BobGlicksman/OpenSourceController/Hardware/ControllerCaseLayout - to scale.pdf

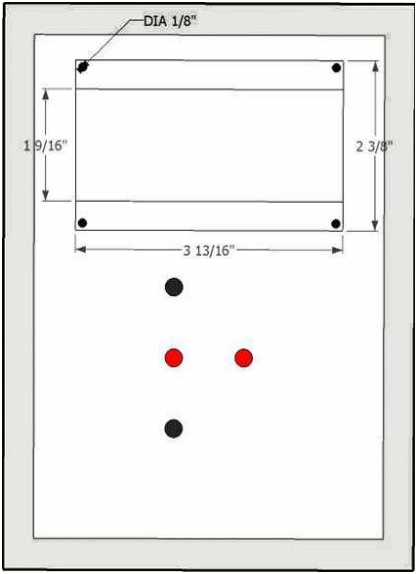
[picture p1: figure]
