BobGlicksman/OpenSourceController/Hardware/Still Controller Parts List - unit and vendor sorted.xls

Sheet: Parts
Assembly | Qty | Device | Description | From | Part Num | URL | Price | Total | Notes
Controller Box | 1 | Box | Plastic box, 1.75L, 3"H x 7"W x 9-1/2"D, Clear | Office Depot | -- | http://www.officedepot.com/a/products/452333/Really-Useful-Boxes-Plastic-Storage-Box/#firstTab | $4.49 | $4.49 | OEM is "Really Useful Boxes". Can be ordered on-line from Office Deport or the OEM, or purchased at Office Depot retail store.
 | 1 | Arduino Uno R3 | Microcontroller | Jameco | A000066 | http://www.jameco.com/webapp/wcs/stores/servlet/Product_10001_10001_2151486_-1 | $29.95 | $29.95 | Also available from Adafruit, Sparkfun Electronics and others
 | 1 | LCD Module | 20x4 character LCD module with I2C interface | B2QCShop | -- | http://b2cqshop.com/products/192-arduino-i2c-serial-2004-lcd-module-20x4-iic-twi-lcd.aspx | $18.50 | $18.50 | Alternate module and I2C backboard are available from Adafruit Industries, but costs more and takes some assembly
 | 2 | Pushbutton | Pushbutton Switch - red | Tayda Electronics | A-5051 | http://www.taydaelectronics.com/electromechanical/switches-key-pad/push-button/pb-11d02-push-button-panel-mount-spst-no-pb-11d02-th1r00.html | $0.22 | $0.44 | Also available at Radio Shack stores
 | 2 | Pushbutton | Pushbutton Switch - black | Tayda Electronics | A-5050 | http://www.taydaelectronics.com/electromechanical/switches-key-pad/push-button/pb-11d02-push-button-panel-mount-spst-no-pb-11d02-th1-00.html | $0.25 | $0.50 | Also available at Radio Shack stores
 | 1 | Power Supply | 9 VDC, 1000 ma switching power supply | Adafruit | 63 | http://www.adafruit.com/products/63 | $6.95 | $6.95
 | 1 | Audible Alert | Piezo electric tone buzzer | Tayda Electronics | A-5019 | http://www.taydaelectronics.com/piezo-electronic-tone-buzzer-alarm-1-5-28v-pcb.html | $1.12 | $1.12 | A similar model with leads is available from this source as well.
 | 2 | Terminal Block | Terminal Block - 8 position | Jameco | 231036 | http://www.jameco.com/webapp/wcs/stores/servlet/ProductDisplay?langId=-1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 | $2.89 | $5.78
 | 1 | Terminal Block | Terminal Block - 3 position | Jameco | 230981 | http://www.jameco.com/webapp/wcs/stores/servlet/ProductDisplay?langId=-1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 | $1.49 | $1.49
 | 6 | Jumper | Terminal Block Jumper | Jameco | 659382 | http://www.jameco.com/webapp/wcs/stores/servlet/ProductDisplay?langId=-1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 | $0.29 | $1.74
 | 1 | Nylon Screw | Bag of #4-40 Nylon screw, 1/2" | Fry's Electronics | 3579664 | http://www.frys.com/product/3579664?site=sr:SEARCH:MAIN_RSLT_PG | $1.95 | $1.95 | Can be purchased in most any hardware store
 | 8 | Nylon Nut | #4-40 Nylon nut, 2 pack | Home Depot | 594623 | http://www.homedepot.com/h_d1/N-5yc1v/R-202210238/h_d2/ProductDisplay?langId=-1&storeId=10051&catalogId=10053 | $0.37 | $2.96 | Can be purchased in most any hardware store
 | 12 | Machine Screw | #6-32 machine screw, 1/2" | Home Depot | 749347 | http://www.homedepot.com/h_d1/N-5yc1v/R-202209804/h_d2/ProductDisplay?langId=-1&storeId=10051&catalogId=10053 | $0.47 | $5.64 | Can be purchased in most any hardware store
 | 6 | Nut | #6-32 nut, pack of 4 | Home Depot | 254827 | http://www.homedepot.com/h_d1/N-5yc1v/R-202706349/h_d2/ProductDisplay?langId=-1&storeId=10051&catalogId=10053 | $1.18 | $7.08 | Can be purchased in most any hardware store
 | 1 | Cable for LCD | 2 pcs, cables for I2C Serial LCD module | B2QCShop | -- | http://b2cqshop.com/products/193-2-pcs-cables-for-iic-serial-lcd-module-i2c-for-arduino-diy.aspx | $3.00 | $3.00
 | 1 | 6-pin wire jumpers | 6 pcs, 6 pin wire jumper cables | B2QCShop | -- | http://b2cqshop.com/products/170-6-pcs-6-pin-wire-jumpers-female-to-female-for-arduino.aspx | $4.50 | $4.50
Subtotal - Controller Box |  |  |  |  |  |  |  | $96.09
Shield Board | 1 | PC Board | Arduino shield printed circuit board for open source controller | BatchPCB |  | http://www.batchpcb.com/product_info.php?products_id=75513&check=a69606452bf49d346372d5d822638f62 | $13.80 | $13.80
 | 1 | Header kit | Set of 4 headers for Arduino Uno shield board | Jameco | 2137756 | http://www.jameco.com/webapp/wcs/stores/servlet/ProductDisplay?langId=-1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 | $1.75 | $1.75
 | 1 | Pin Header, male | 40 position header, 0.1", breakable | Jameco | 7000-1X40SG-R | http://www.jameco.com/webapp/wcs/stores/servlet/Product_10001_10001_160882_-1 | $0.65 | $0.65
 | 2 | 16 pin DIP socket | 16 pin DIP socket, solder tail, 0.3" wide | Jameco | 6100-16-R | http://www.jameco.com/webapp/wcs/stores/servlet/Product_10001_10001_37402_-1 | $0.75 | $1.50
 | 1 | 10 pin SIP socket | 10 pin SIP socket, solder tail | Jameco | 6100-1X10-R (http://www.jameco.com/webapp/wcs/stores/servlet/Product_10001_10001_102201_-1) | http://www.jameco.com/webapp/wcs/stores/servlet/Product_10001_10001_102201_-1 | $1.19 | $1.19
 | 1 | 74HC165 | 74HC165 octal, latched, shift in register, 16 pin DIP | Tayda Electronics | A-639 | http://www.taydaelectronics.com/74hc165-74165-ic-8-bit-shift-register.html | $0.34 | $0.34
 | 1 | 74HC595 | 74HC595 octal, latched, shift out register, 16 pin DIP | Tayda Electronics | A-251 | http://www.taydaelectronics.com/74hc595-8-bit-shift-register-ic.html | $0.20 | $0.20
 | 1 | Resistor network | 10 pin, pull-up resistor network, 4.7K ohm | Jameco | 10BRN4.7K | http://www.jameco.com/webapp/wcs/stores/servlet/Product_10001_10001_24660_-1 | $0.19 | $0.19
 | 1 | capacitor, 100 uf | 100 uf electrolytic capacitor | Tayda Electronics | A-4514 | http://www.taydaelectronics.com/capacitors/electrolytic-capacitors/100uf-10v-105c-radial-electrolytic-capacitor-5x11mm.html | $0.02 | $0.02
 | 1 | capacitor, 0.01 uf | 0.01 uf ceramic capacitor, package of 10 | Tayda Electronics | A-550 | http://www.taydaelectronics.com/capacitors/ceramic-disc-capacitors/10-x-0-01uf-50v-ceramic-disc-capacitor-pkg-of-10.html | $0.10 | $0.10
 | 1 | LED | Yellow LED - 5 mm | Sparkfun | COM-00532 | http://www.sparkfun.com/products/532 | $0.35 | $0.35
 | 10 | resistor, 560 ohm | unit of 10 resistors, 560 ohm, 1/4 watt | Tayda Electronics | A-2282 | http://www.taydaelectronics.com/10-x-resistor-560-ohm-1-4w-1-metal-film-pkg-of-10.html | $0.01 | $0.10
 | 1 | switch | N.O. pushbutton switch, PC mount | Sparkfun | COM-0097 | http://www.sparkfun.com/products/97 | $0.35 | $0.35
Subtotal - Shield Board |  |  |  |  |  |  |  | $20.54
Test Board | 1 | Breadboard | Full sized solderless breadboard | Adafruit | 239 | https://www.adafruit.com/products/239 | $8.00 | $8.00
 | 3 | Screw Terminal, 3 pos | Connector terminal block, 3 position, 5.08 mm, solder straight through | Jameco | 152355 | http://www.jameco.com/webapp/wcs/stores/servlet/ProductDisplay?langId=-1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 | $0.49 | $1.47
 | 1 | Screw Terminal, 2 pos | Connector terminal block, 3 position, 5.08 mm, solder straight through | Jameco | 152347 | http://www.jameco.com/webapp/wcs/stores/servlet/ProductDisplay?langId=-1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 | $0.65 | $0.65
 | 7 | LED | Yellow LED - 5 mm | Sparkfun | COM-00532 | http://www.sparkfun.com/products/532 | $0.35 | $2.45
 | 0 | resistor, 560 ohm | unit of 10 resistors, 560 ohm, 1/4 watt | Tayda Electronics | A-2282 | http://www.taydaelectronics.com/10-x-resistor-560-ohm-1-4w-1-metal-film-pkg-of-10.html | $0.01 | $0.00 | included in item #31
 | 1 | Jumper Wires | Bag of 10, 6" M/M jumpers | Sparkfun Electronics | PRT-08431 | http://www.sparkfun.com/products/8431 | $3.95 | $3.95
 | 3 | DS18B20 | One-wire bus temperature sensor | Tayda Electronics | A-072 | http://www.taydaelectronics.com/ic-integrated-circuits/temperature-sensors/ds18b20-1-wire-digital-temperature-sensor-ic-dallas.html | $1.75 | $5.25
Subtotal - Test Board |  |  |  |  |  |  |  | $21.77
Misc | 1 | USB Cable | USB Cable, A-B, 3 ft. | Adafruit | 62 | http://www.adafruit.com/products/62 | $4.00 | $4.00
 | 1 | Hookup Wire | 22 AWG stranded, 25' ea. Red, green and black | Radio Sack | 278-1224 | http://www.radioshack.com/product/index.jsp?productId=2049745 | $7.49 | $7.49
 | 1 | Solder | 8 oz roll of rosin core solder | Radio Shack | 64-009 | http://www.radioshack.com/product/index.jsp?productId=2062715 | $11.99 | $11.99
 | 100 | Cable Ties | Bag of cable ties | Jameco | 70561 | http://www.jameco.com/webapp/wcs/stores/servlet/Product_10001_10001_70561_-1?CID=PDF | $0.03 | $3.00
 | 15 | Tie Mounts | Nylon cable tie mount, 3/4 inch, adhesive | Jameco | 182942 | http://www.jameco.com/webapp/wcs/stores/servlet/Product_10001_10001_182942_-1 | $0.15 | $2.25
Subtotal - Misc |  |  |  |  |  |  |  | $28.73
TOTAL |  |  |  |  |  |  |  | $167.13

Sheet: Order
Controller Box | 1 | Power Supply | 9 VDC, 1000 ma switching power supply | Adafruit | 63 | http://www.adafruit.com/products/63 | $6.95 | $6.95
Misc | 1 | USB Cable | USB Cable, A-B, 3 ft. | Adafruit | 62 | http://www.adafruit.com/products/62 | $4.00 | $4.00
Test Board | 1 | Breadboard | Full sized solderless breadboard | Adafruit | 239 | https://www.adafruit.com/products/239 | $8.00 | $8.00
Controller Box | 1 | LCD Module | 20x4 character LCD module with I2C interface | B2QCShop | -- | http://b2cqshop.com/products/192-arduino-i2c-serial-2004-lcd-module-20x4-iic-twi-lcd.aspx | $18.50 | $18.50 | Alternate module and I2C backboard are available from Adafruit Industries, but costs more and takes some assembly
Controller Box | 1 | Cable for LCD | 2 pcs, cables for I2C Serial LCD module | B2QCShop | -- | http://b2cqshop.com/products/193-2-pcs-cables-for-iic-serial-lcd-module-i2c-for-arduino-diy.aspx | $3.00 | $3.00
Controller Box | 1 | 6-pin wire jumpers | 6 pcs, 6 pin wire jumper cables | B2QCShop | -- | http://b2cqshop.com/products/170-6-pcs-6-pin-wire-jumpers-female-to-female-for-arduino.aspx | $4.50 | $4.50
Shield Board | 1 | PC Board | Arduino shield printed circuit board for open source controller | BatchPCB |  | http://www.batchpcb.com/product_info.php?products_id=75513&check=a69606452bf49d346372d5d822638f62 | $13.80 | $13.80
Controller Box | 1 | Nylon Screw | Bag of #4-40 Nylon screw, 1/2" | Fry's Electronics | 3579664 | http://www.frys.com/product/3579664?site=sr:SEARCH:MAIN_RSLT_PG | $1.95 | $1.95 | Can be purchased in most any hardware store
Controller Box | 8 | Nylon Nut | #4-40 Nylon nut, 2 pack | Home Depot | 594623 | http://www.homedepot.com/h_d1/N-5yc1v/R-202210238/h_d2/ProductDisplay?langId=-1&storeId=10051&catalogId=10053 | $0.37 | $2.96 | Can be purchased in most any hardware store
Controller Box | 12 | Machine Screw | #6-32 machine screw, 1/2" | Home Depot | 749347 | http://www.homedepot.com/h_d1/N-5yc1v/R-202209804/h_d2/ProductDisplay?langId=-1&storeId=10051&catalogId=10053 | $0.47 | $5.64 | Can be purchased in most any hardware store
Controller Box | 6 | Nut | #6-32 nut, pack of 4 | Home Depot | 254827 | http://www.homedepot.com/h_d1/N-5yc1v/R-202706349/h_d2/ProductDisplay?langId=-1&storeId=10051&catalogId=10053 | $1.18 | $7.08 | Can be purchased in most any hardware store
Controller Box | 1 | Arduino Uno R3 | Microcontroller | Jameco | A000066 | http://www.jameco.com/webapp/wcs/stores/servlet/Product_10001_10001_2151486_-1 | $29.95 | $29.95 | Also available from Adafruit, Sparkfun Electronics and others
Controller Box | 2 | Terminal Block | Terminal Block - 8 position | Jameco | 231036 | http://www.jameco.com/webapp/wcs/stores/servlet/ProductDisplay?langId=-1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 | $2.89 | $5.78
Controller Box | 1 | Terminal Block | Terminal Block - 3 position | Jameco | 230981 | http://www.jameco.com/webapp/wcs/stores/servlet/ProductDisplay?langId=-1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 | $1.49 | $1.49
Controller Box | 6 | Jumper | Terminal Block Jumper | Jameco | 659382 | http://www.jameco.com/webapp/wcs/stores/servlet/ProductDisplay?langId=-1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 | $0.29 | $1.74
Misc | 100 | Cable Ties | Bag of cable ties | Jameco | 70561 | http://www.jameco.com/webapp/wcs/stores/servlet/Product_10001_10001_70561_-1?CID=PDF | $0.03 | $3.00
Misc | 15 | Tie Mounts | Nylon cable tie mount, 3/4 inch, adhesive | Jameco | 182942 | http://www.jameco.com/webapp/wcs/stores/servlet/Product_10001_10001_182942_-1 | $0.15 | $2.25
Shield Board | 1 | Header kit | Set of 4 headers for Arduino Uno shield board | Jameco | 2137756 | http://www.jameco.com/webapp/wcs/stores/servlet/ProductDisplay?langId=-1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 | $1.75 | $1.75
Shield Board | 1 | Pin Header, male | 40 position header, 0.1", breakable | Jameco | 7000-1X40SG-R | http://www.jameco.com/webapp/wcs/stores/servlet/Product_10001_10001_160882_-1 | $0.65 | $0.65
Shield Board | 2 | 16 pin DIP socket | 16 pin DIP socket, solder tail, 0.3" wide | Jameco | 6100-16-R | http://www.jameco.com/webapp/wcs/stores/servlet/Product_10001_10001_37402_-1 | $0.75 | $1.50
Shield Board | 1 | 10 pin SIP socket | 10 pin SIP socket, solder tail | Jameco | 6100-1X10-R (http://www.jameco.com/webapp/wcs/stores/servlet/Product_10001_10001_102201_-1) | http://www.jameco.com/webapp/wcs/stores/servlet/Product_10001_10001_102201_-1 | $1.19 | $1.19
Shield Board | 1 | Resistor network | 10 pin, pull-up resistor network, 4.7K ohm | Jameco | 10BRN4.7K | http://www.jameco.com/webapp/wcs/stores/servlet/Product_10001_10001_24660_-1 | $0.19 | $0.19
Test Board | 3 | Screw Terminal, 3 pos | Connector terminal block, 3 position, 5.08 mm, solder straight through | Jameco | 152355 | http://www.jameco.com/webapp/wcs/stores/servlet/ProductDisplay?langId=-1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 | $0.49 | $1.47
Test Board | 1 | Screw Terminal, 2 pos | Connector terminal block, 3 position, 5.08 mm, solder straight through | Jameco | 152347 | http://www.jameco.com/webapp/wcs/stores/servlet/ProductDisplay?langId=-1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 | $0.65 | $0.65
Controller Box | 1 | Box | Plastic box, 1.75L, 3"H x 7"W x 9-1/2"D, Clear | Office Depot | -- | http://www.officedepot.com/a/products/452333/Really-Useful-Boxes-Plastic-Storage-Box/#firstTab | $4.49 | $4.49 | OEM is "Really Useful Boxes". Can be ordered on-line from Office Deport or the OEM, or purchased at Office Depot retail store.
Misc | 1 | Hookup Wire | 22 AWG stranded, 25' ea. Red, green and black | Radio Sack | 278-1224 | http://www.radioshack.com/product/index.jsp?productId=2049745 | $7.49 | $7.49
Misc | 1 | Solder | 8 oz roll of rosin core solder | Radio Shack | 64-009 | http://www.radioshack.com/product/index.jsp?productId=2062715 | $11.99 | $11.99
Shield Board | 1 | LED | Yellow LED - 5 mm | Sparkfun | COM-00532 | http://www.sparkfun.com/products/532 | $0.35 | $0.35
Shield Board | 1 | switch | N.O. pushbutton switch, PC mount | Sparkfun | COM-0097 | http://www.sparkfun.com/products/97 | $0.35 | $0.35
Test Board | 7 | LED | Yellow LED - 5 mm | Sparkfun | COM-00532 | http://www.sparkfun.com/products/532 | $0.35 | $2.45
Test Board | 1 | Jumper Wires | Bag of 10, 6" M/M jumpers | Sparkfun Electronics | PRT-08431 | http://www.sparkfun.com/products/8431 | $3.95 | $3.95
Controller Box | 2 | Pushbutton | Pushbutton Switch - red | Tayda Electronics | A-5051 | http://www.taydaelectronics.com/electromechanical/switches-key-pad/push-button/pb-11d02-push-button-panel-mount-spst-no-pb-11d02-th1r00.html | $0.22 | $0.44 | Also available at Radio Shack stores
Controller Box | 2 | Pushbutton | Pushbutton Switch - black | Tayda Electronics | A-5050 | http://www.taydaelectronics.com/electromechanical/switches-key-pad/push-button/pb-11d02-push-button-panel-mount-spst-no-pb-11d02-th1-00.html | $0.25 | $0.50 | Also available at Radio Shack stores
Controller Box | 1 | Audible Alert | Piezo electric tone buzzer | Tayda Electronics | A-5019 | http://www.taydaelectronics.com/piezo-electronic-tone-buzzer-alarm-1-5-28v-pcb.html | $1.12 | $1.12 | A similar model with leads is available from this source as well.
Shield Board | 1 | 74HC165 | 74HC165 octal, latched, shift in register, 16 pin DIP | Tayda Electronics | A-639 | http://www.taydaelectronics.com/74hc165-74165-ic-8-bit-shift-register.html | $0.34 | $0.34
Shield Board | 1 | 74HC595 | 74HC595 octal, latched, shift out register, 16 pin DIP | Tayda Electronics | A-251 | http://www.taydaelectronics.com/74hc595-8-bit-shift-register-ic.html | $0.20 | $0.20
Shield Board | 1 | capacitor, 100 uf | 100 uf electrolytic capacitor | Tayda Electronics | A-4514 | http://www.taydaelectronics.com/capacitors/electrolytic-capacitors/100uf-10v-105c-radial-electrolytic-capacitor-5x11mm.html | $0.02 | $0.02
Shield Board | 1 | capacitor, 0.01 uf | 0.01 uf ceramic capacitor, package of 10 | Tayda Electronics | A-550 | http://www.taydaelectronics.com/capacitors/ceramic-disc-capacitors/10-x-0-01uf-50v-ceramic-disc-capacitor-pkg-of-10.html | $0.10 | $0.10
Shield Board | 10 | resistor, 560 ohm | unit of 10 resistors, 560 ohm, 1/4 watt | Tayda Electronics | A-2282 | http://www.taydaelectronics.com/10-x-resistor-560-ohm-1-4w-1-metal-film-pkg-of-10.html | $0.01 | $0.10
Test Board | 0 | resistor, 560 ohm | unit of 10 resistors, 560 ohm, 1/4 watt | Tayda Electronics | A-2282 | http://www.taydaelectronics.com/10-x-resistor-560-ohm-1-4w-1-metal-film-pkg-of-10.html | $0.01 | $0.00 | included in item #31
Test Board | 3 | DS18B20 | One-wire bus temperature sensor | Tayda Electronics | A-072 | http://www.taydaelectronics.com/ic-integrated-circuits/temperature-sensors/ds18b20-1-wire-digital-temperature-sensor-ic-dallas.html | $1.75 | $5.25
