BobGlicksman/OpenSourceController/Hardware/Open Source Controller Shield.pdf

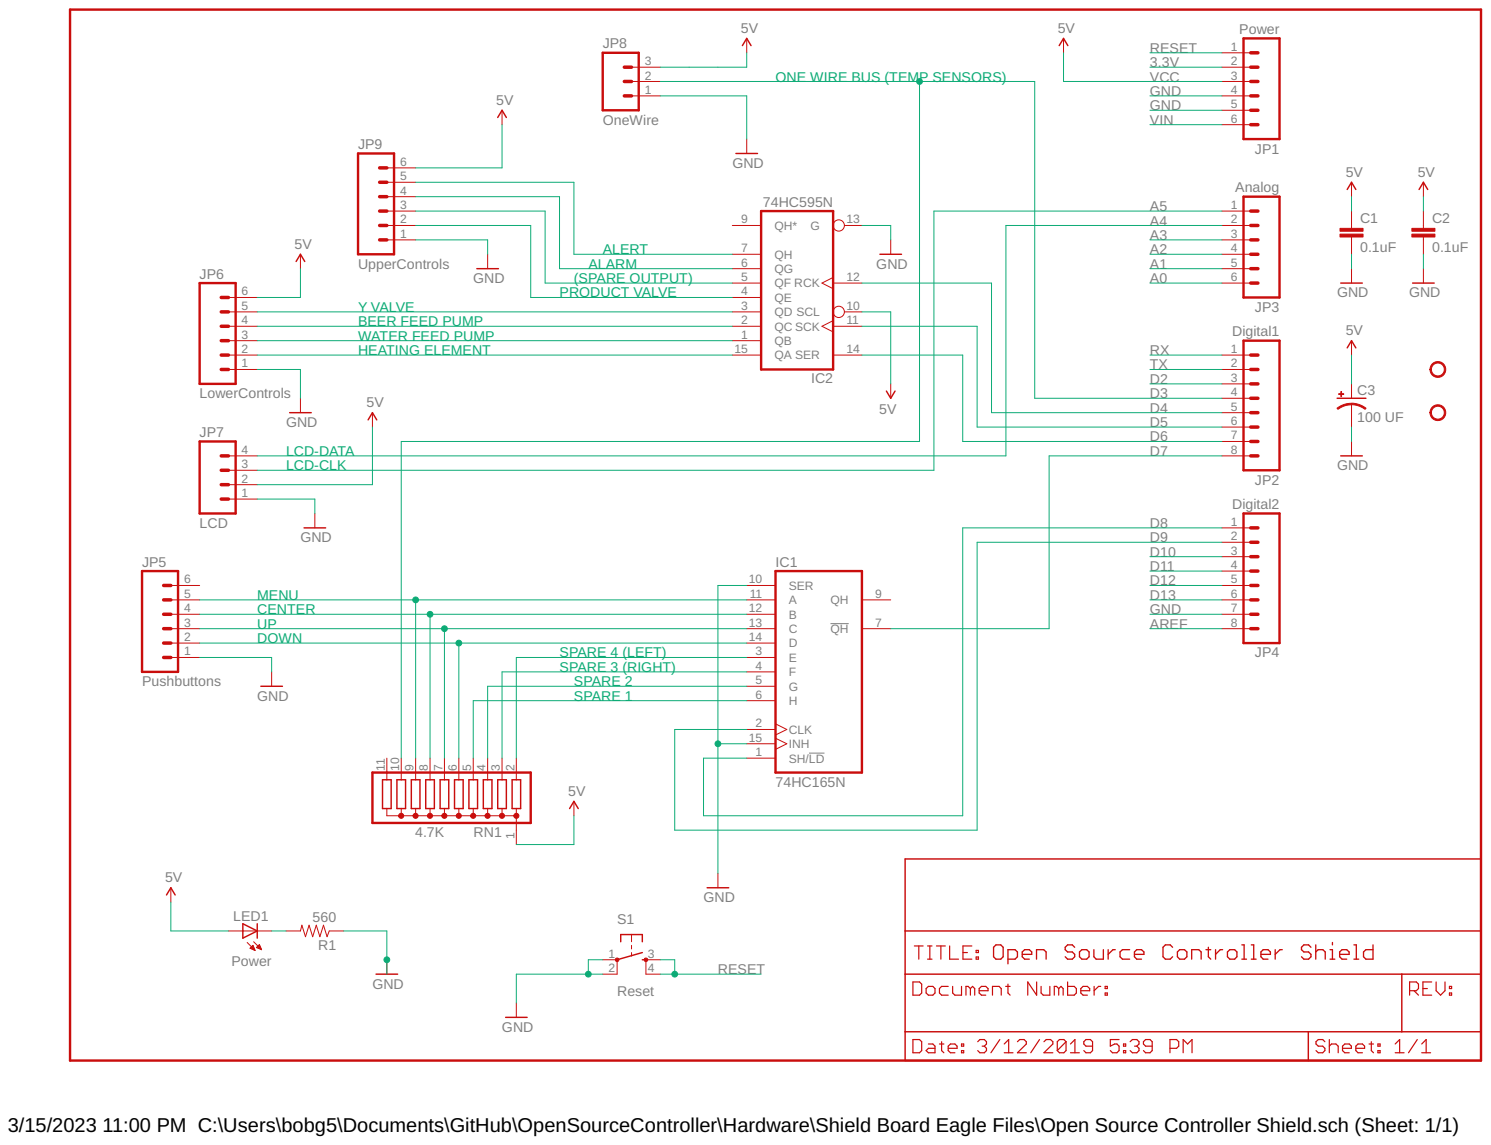
[picture p5: page 1]

ONE WIRE BUS (TEMP SENSORS)

D9 2
D10 3

3/15/2023 11:00 PM C:\Users\bobg5\Documents\GitHub\OpenSourceController\Hardware\Shield Board Eagle Files\Open Source Controller Shield.sch (Sheet: 1/1)
