BobGlicksman/OpenSourceController/Hardware/Shield Board Eagle Files/Open Source Controller Shield.pdf

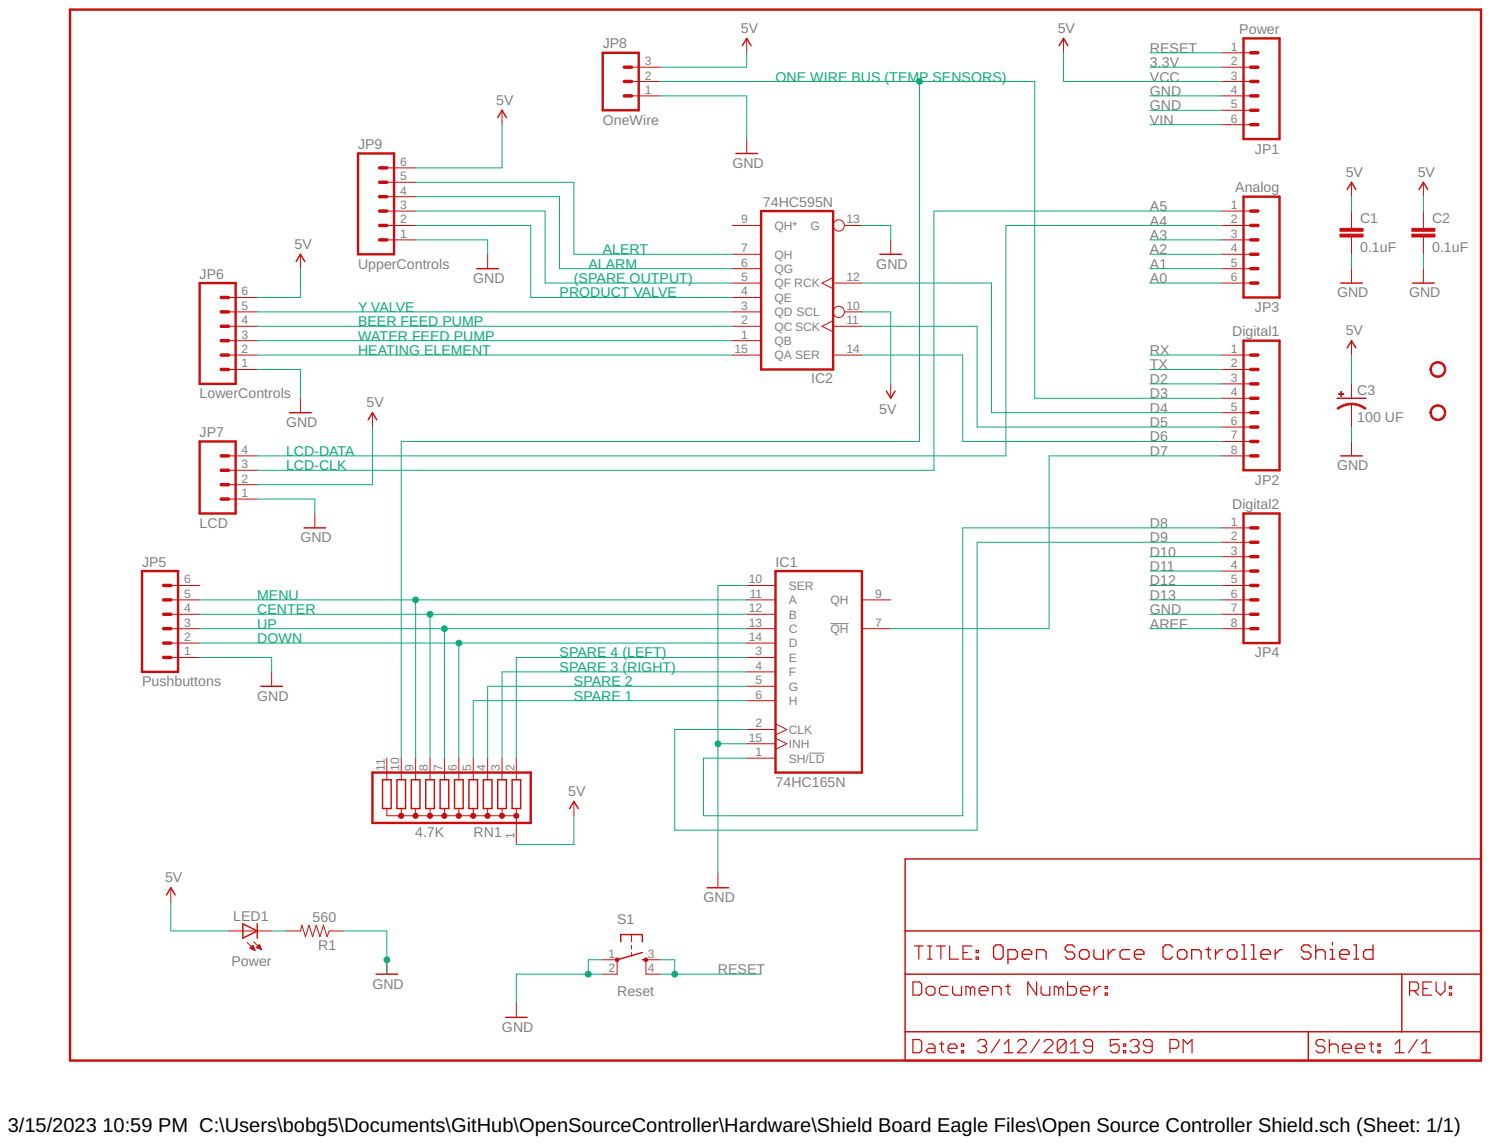
[picture p6: page 1]

ONE WIRE BUS (TEMP SENSORS)

D9 2
D10 3

3/15/2023 10:59 PM C:\Users\bobg5\Documents\GitHub\OpenSourceController\Hardware\Shield Board Eagle Files\Open Source Controller Shield.sch (Sheet: 1/1)
