BobGlicksman/OpenSourceController/(commit log)

2016-12-02 Release Package
    Complete set of documentation
    [Open Source Controller Shield.brd, Open Source Controller Shield.sch, Still Controller Parts List - unit and vendor sorted.xls]
2016-12-02 Edited the read_me
    Added note that Arduino 022 is required.
2023-03-16 PDF version of shield board schematic
